IldusV/smartwatch/README.md

1. Download https://github.com/lvgl/lvgl library into the root directory of the smartwatch project
3. Add fb_tft display driver into linux kerner directory for GC9A01A  
4. Add CST816S touchscreen driver into the kernel directory
5. Configure Device Tree
