IldusV/smartwatch/(threads)

Thread 3 (2024-05-27):

GUI stuck

IldusV, 2024-05-27:
However evdev handler for example seem to be running since it still prints touches.

IldusV, 2024-06-18:
This problem seems to be coming up because of animation. Without an animation clock run for a couple of hours without issue.
