IldusV/smartwatch/hardware/PCB/Smartwatch_rev_B.pdf

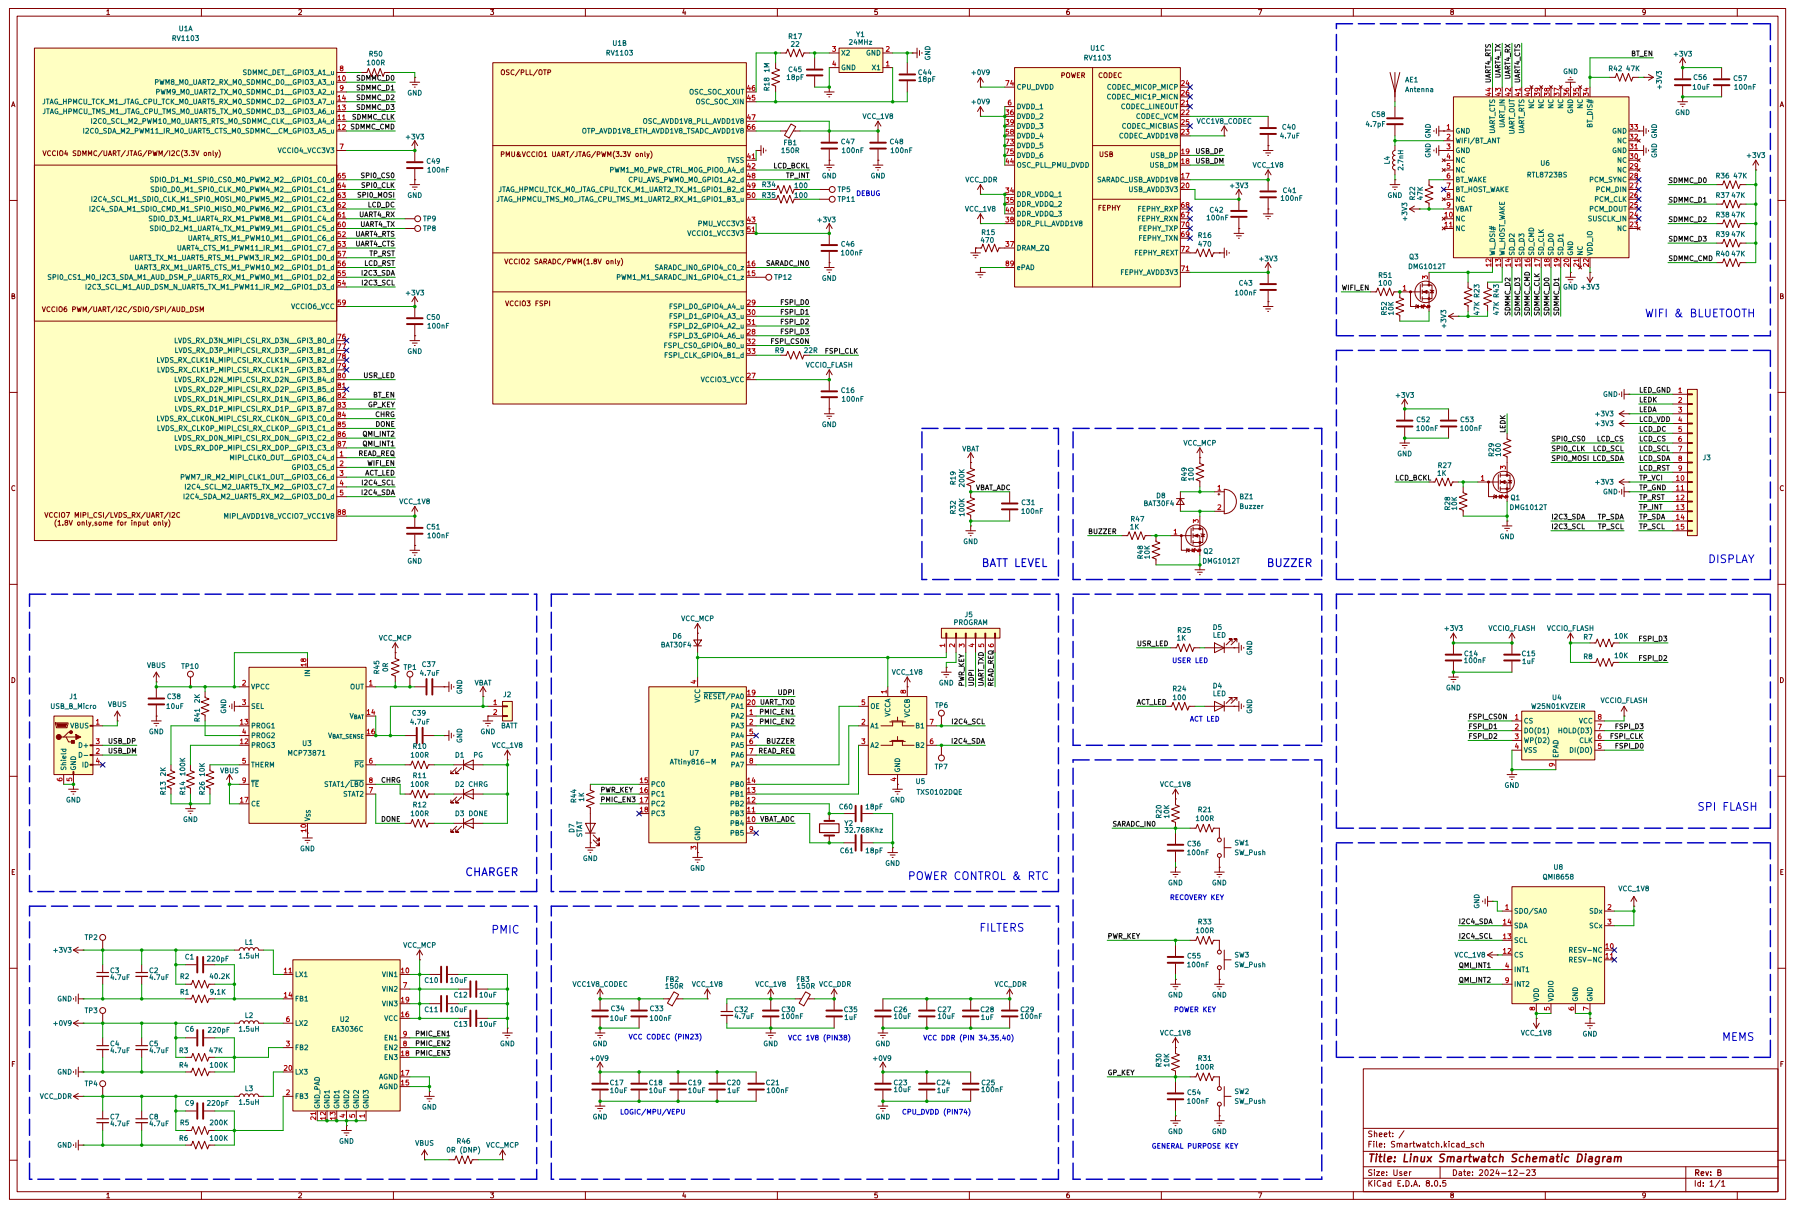
[picture p1: page 1]
