IldusV/smartwatch/hardware/PCB/Smartwatch_rev_A.pdf

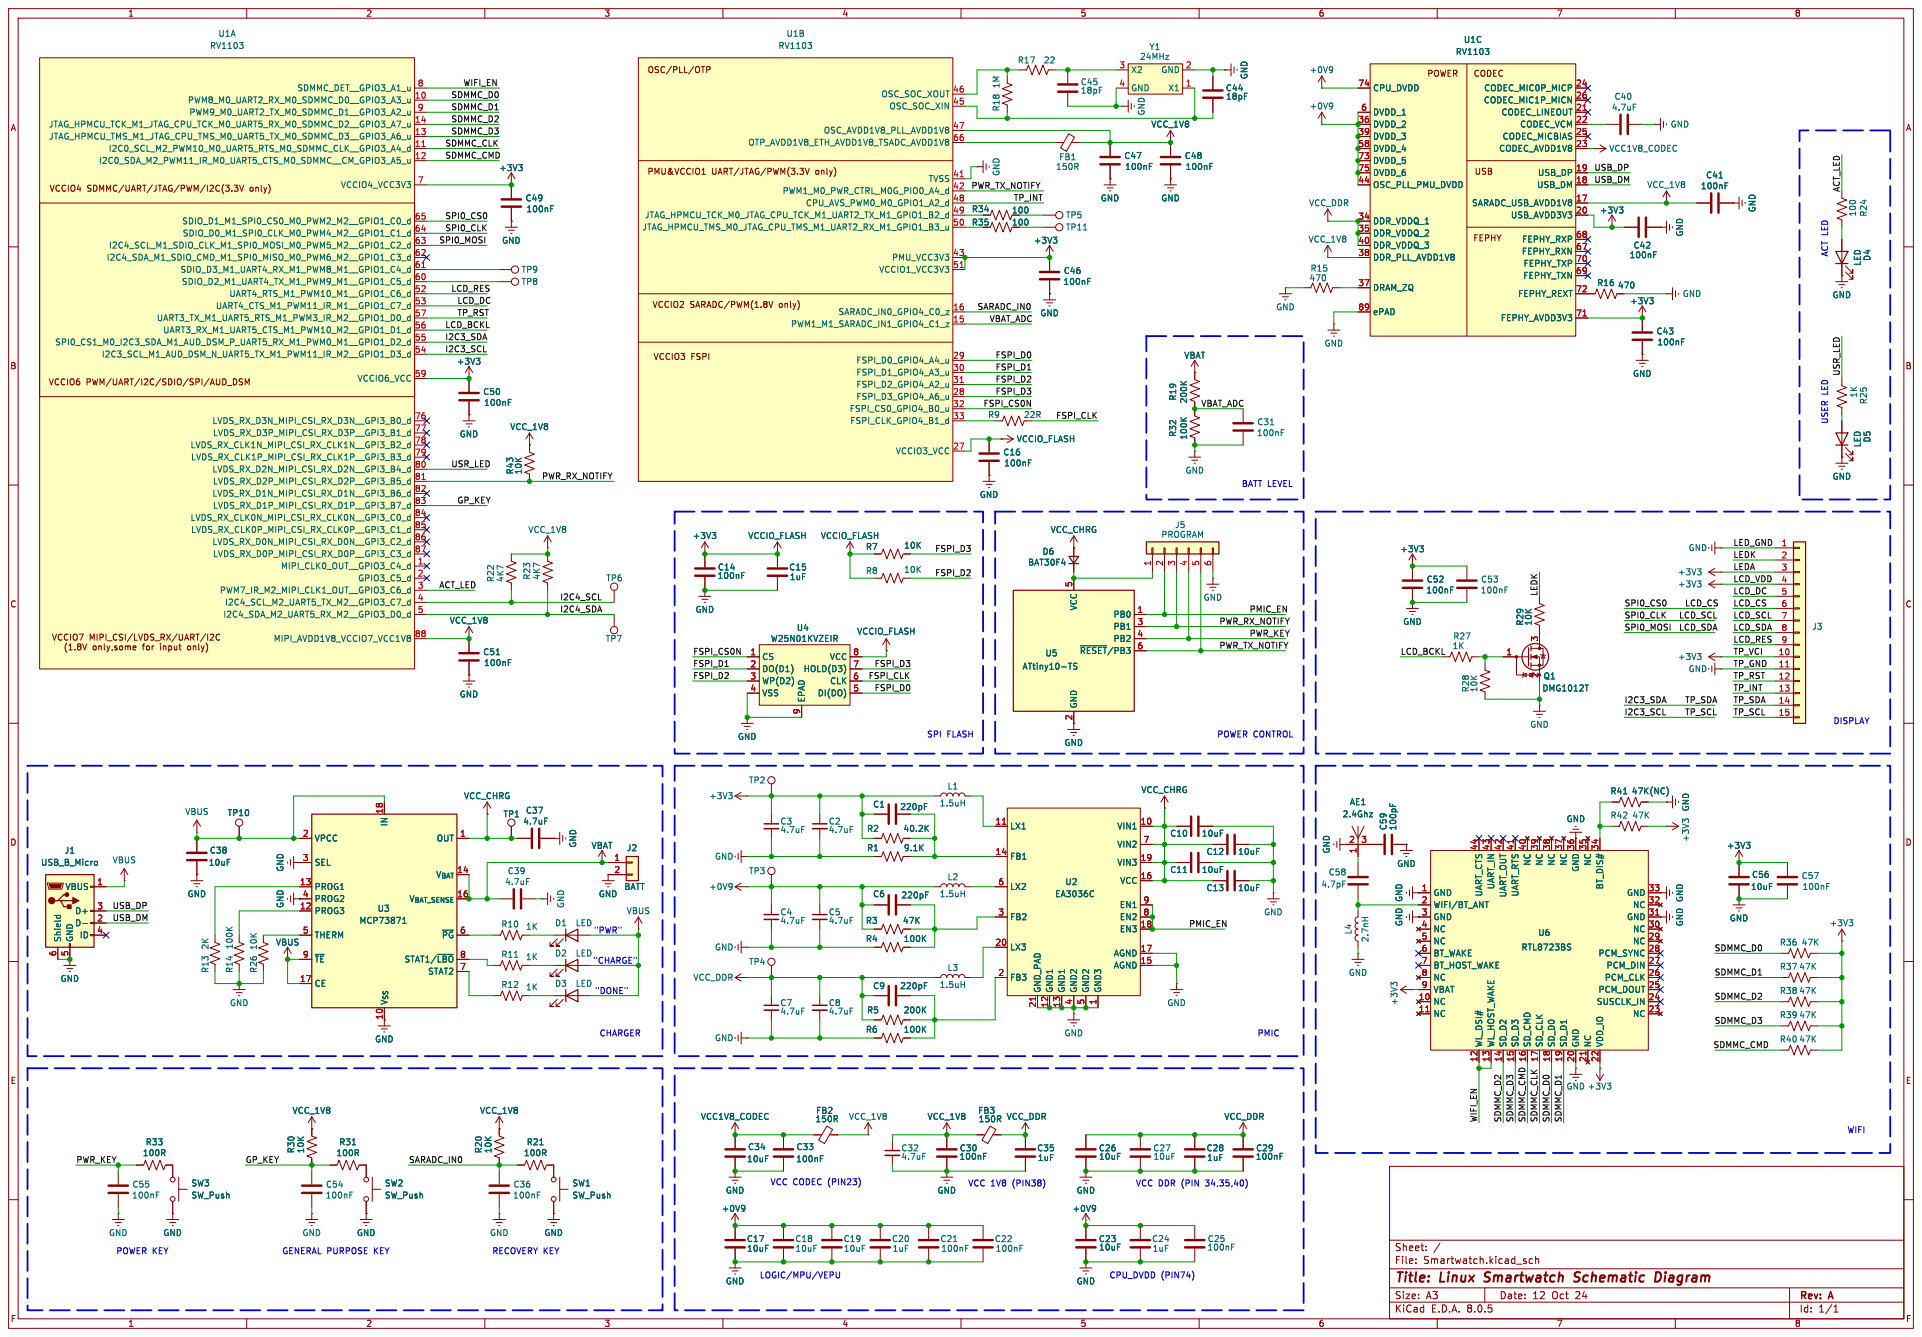
[picture p2: page 1]

VCC CODEC (PIN23) LOGIC/MPU/VEPU GENERAL PURPOSE KEY

Id: 1/1 Title: Linux Smartwatch Schematic Diagram
