IldusV/smartwatch/hardware/PCB/Smartwatch.kicad_pcb

## KiCad design hardware/PCB/Smartwatch.kicad_pcb (2024-10-13)

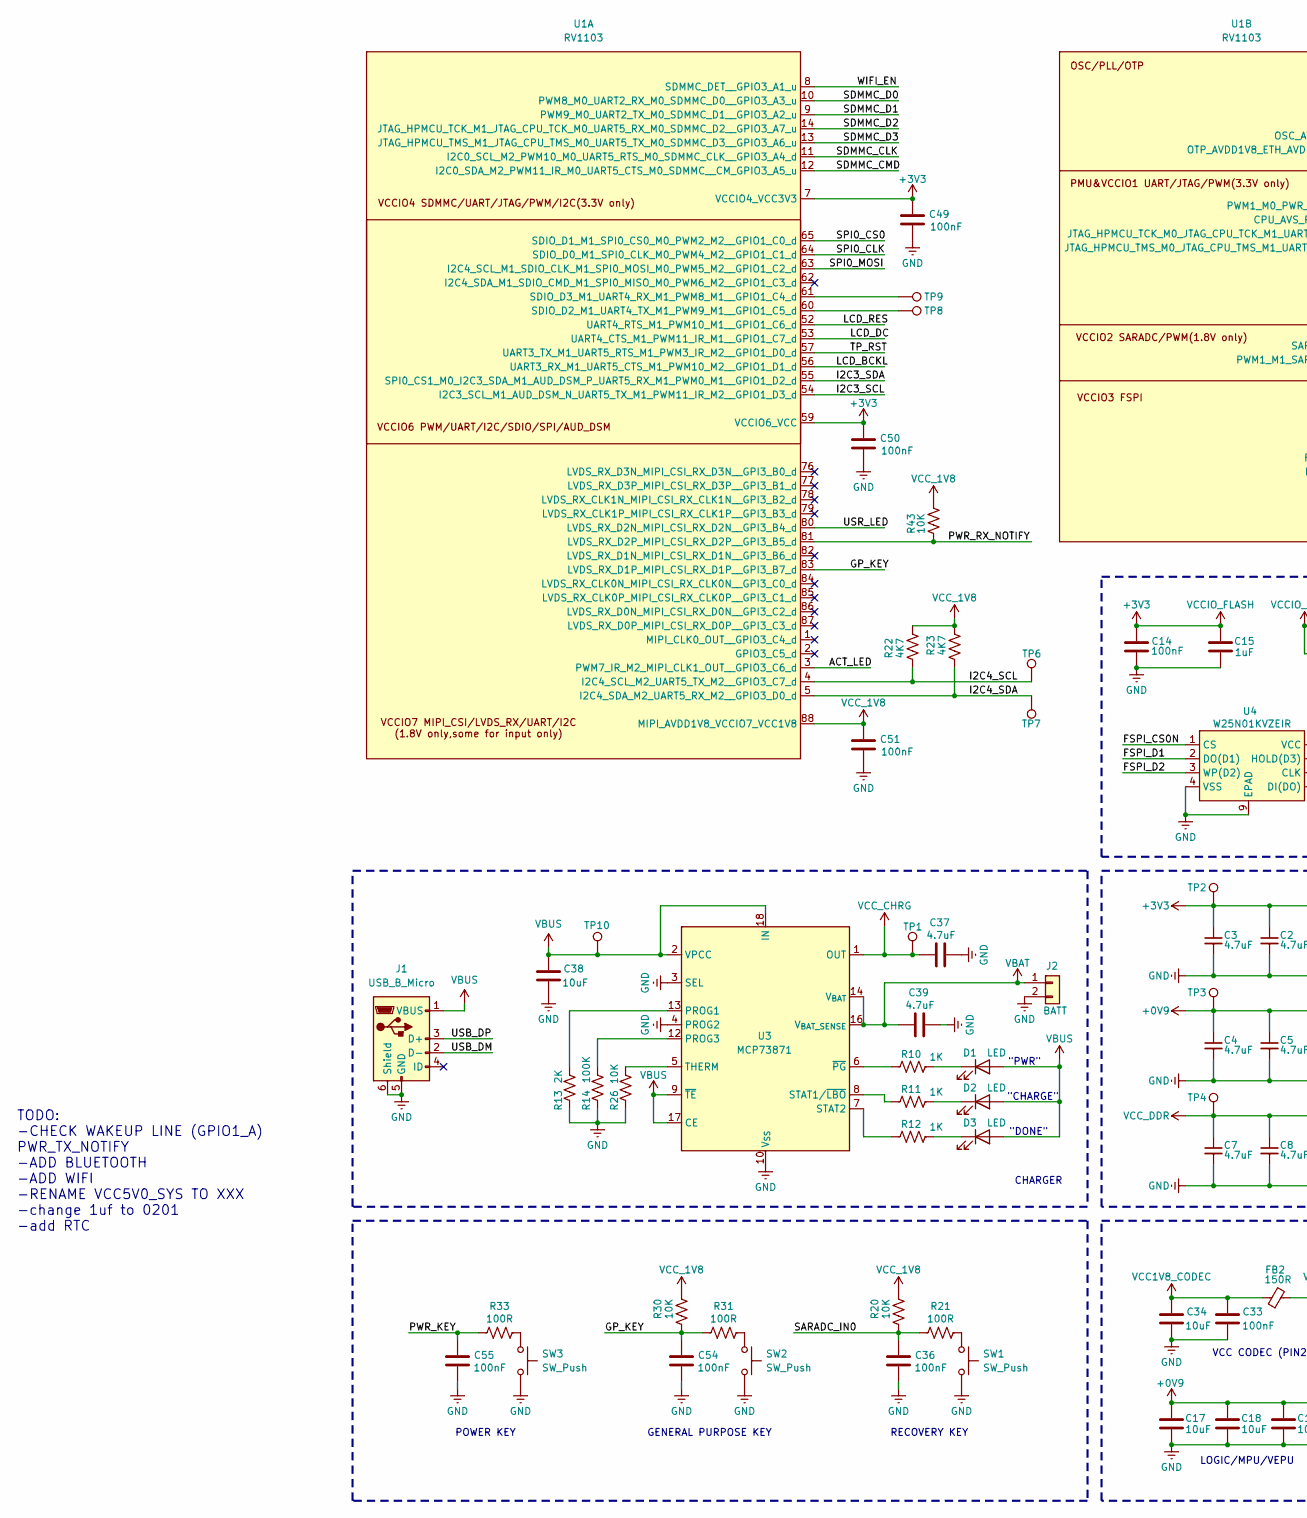
[picture p3: schematic Smartwatch.kicad_sch, Linux Smartwatch Schematic Diagram, part in row 1, column 1]

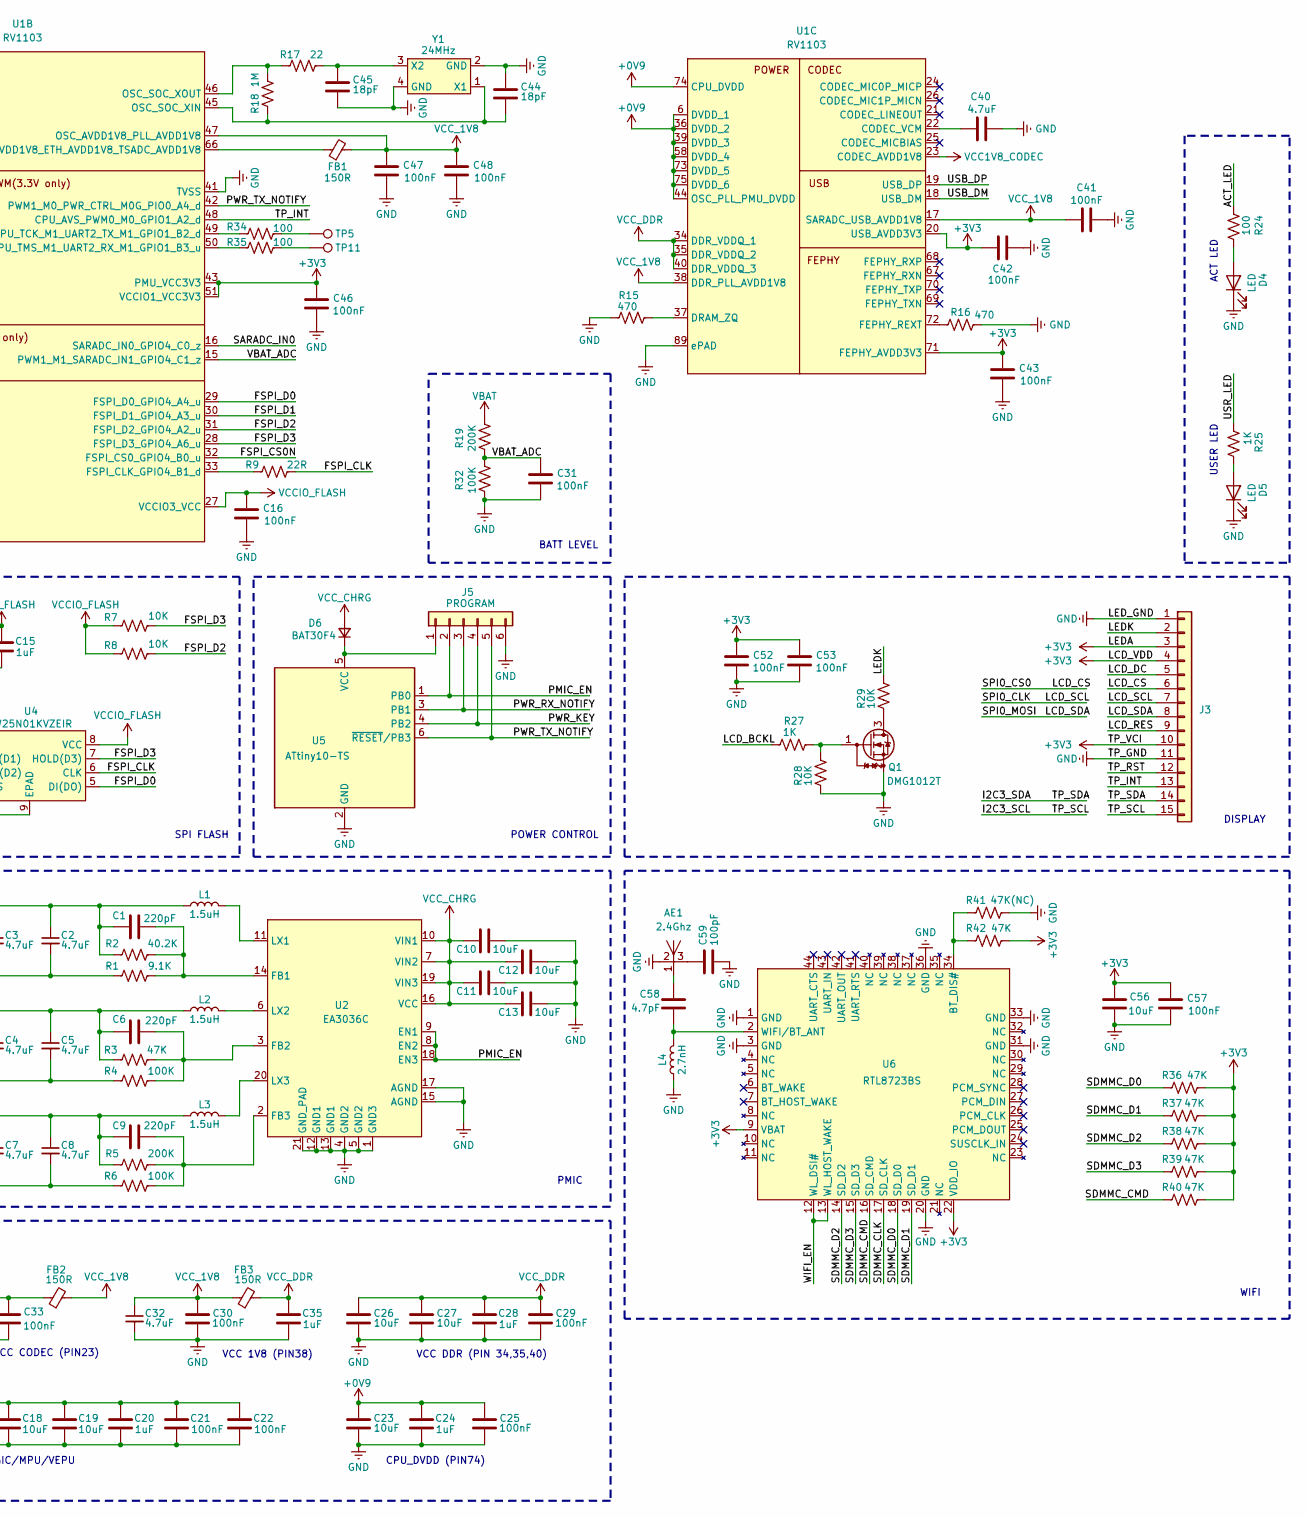
[picture p4: schematic Smartwatch.kicad_sch, Linux Smartwatch Schematic Diagram, part in row 1, column 2]

Parts:
AE1: 2.4Ghz; 2.4Ghz_TE_Antenna
C1, C6, C9: 220pF; C_0201_0603Metric
C2, C3, C4, C5, C7, C8, C32, C37, C39, C40: 4.7uF; C_0201_0603Metric
C10, C11, C12, C13, C17, C18, C19, C23, C26, C27, C34, C38, C56: 10uF; C_0402_1005Metric
C14, C16, C21, C22, C25, C29, C30, C31, C33, C36, C41, C42, C43, C46, C47, C48, C49, C50, C51, C52, C53, C54, C55, C57: 100nF; C_0201_0603Metric
C15, C20, C24, C28, C35: 1uF; C_0201_0603Metric
C44, C45: 18pF; C_0201_0603Metric
C58: 4.7pF; C_0201_0603Metric
C59: 100pF; C_0201_0603Metric
D1, D2, D3, D4, D5: LED; LED_0201_0603Metric
D6: BAT30F4; D_0201_0603Metric
FB1, FB2, FB3: 150R; L_0402_1005Metric
J1: USB_B_Micro; USB_Micro-B_Molex_47346-0001
J2: BATT; JST_Aliexpress_KAN_shop_1x02-1MP_P0.80mm_Horizontal
J3: Conn_01x15; Amphenol_1x15-1MP_P0.5mm_Horizontal
J5: PROGRAM; pinpad6
L1, L2, L3: 1.5uH; L_1008_2520Metric
L4: 2.7nH; L_0402_1005Metric
Q1: DMG1012T; SOT-523
R1: 9.1K; R_0201_0603Metric
R2: 40.2K; R_0201_0603Metric
R3, R36, R37, R38, R39, R40, R42: 47K; R_0201_0603Metric
R4, R6, R14, R32: 100K; R_0201_0603Metric
R5, R19: 200K; R_0201_0603Metric
R7, R8, R20, R26, R28, R29, R30, R43: 10K; R_0201_0603Metric
R9: 22R; R_0201_0603Metric
R10, R11, R12, R25, R27: 1K; R_0201_0603Metric
R13: 2K; R_0201_0603Metric
R15, R16: 470; R_0201_0603Metric
R17: 22; R_0201_0603Metric
R18: 1M; R_0201_0603Metric
R21, R31, R33: 100R; R_0201_0603Metric
R22, R23: 4K7; R_0201_0603Metric
R24, R34, R35: 100; R_0201_0603Metric
R41: 47K(NC); R_0201_0603Metric
SW1, SW2, SW3: SW_Push; SW_1.8x4.5x3.5
TP1, TP2, TP3, TP4, TP5, TP6, TP7, TP8, TP9, TP10, TP11: TestPoint; TP
U1: RV1103; QFN-88_EP_9x9_Pitch0.35mm
U2: EA3036C; QFN-20-1EP_3x3mm_P0.4mm_EP1.65x1.65mm
U3: MCP73871; QFN-20-1EP_4x4mm_P0.5mm_EP2.5x2.5mm
U4: W25N01KVZEIR; WSON-8-1EP_8x6mm_P1.27mm_EP3.4x4.3mm
U5: ATtiny10-TS; SOT-23-6
U6: RTL8723BS; QFN-44_12.64x12.64_Pitch0.9mm
Y1: 24MHz; Crystal_SMD_2016-4Pin_2.0x1.6mm

Connections:
+0V9: C4.1, C5.1, C6.1, C17.1, C18.1, C19.1, C20.1, C21.2, C22.2, C23.1, C24.1, C25.2, L2.1, R3.1, TP3.1, U1.6 (DVDD_1), U1.36 (DVDD_2), U1.39 (DVDD_3), U1.44 (OSC_PLL_PMU_DVDD), U1.58 (DVDD_4), U1.73 (DVDD_5), U1.74 (CPU_DVDD), U1.75 (DVDD_6)
+3V3: C1.1, C2.1, C3.1, C14.2, C15.1, C16.2, C42.2, C43.2, C46.2, C49.2, C50.2, C52.2, C53.2, C56.1, C57.2, J3.3, J3.4, J3.10, L1.1, R2.1, R7.1, R8.1, R36.2, R37.2, R38.2, R39.2, R40.2, R42.2, TP2.1, U1.7 (VCCIO4_VCC3V3), U1.20 (USB_AVDD3V3), U1.27 (VCCIO3_VCC), U1.43 (PMU_VCC3V3), U1.51 (VCCIO1_VCC3V3), U1.59 (VCCIO6_VCC), U1.71 (FEPHY_AVDD3V3), U4.8 (VCC), U6.9 (VBAT), U6.22 (VDD_IO)
/ACT_LED: R24.1, U1.3 (PWM7_IR_M2_MIPI_CLK1_OUT__GPIO3_C6_d)
/FSPI_CLK: R9.2, U4.6 (CLK)
/FSPI_CS0N: U1.32 (FSPI_CS0_GPIO4_B0_u), U4.1 (CS)
/FSPI_D0: U1.29 (FSPI_D0_GPIO4_A4_u), U4.5 (DI(DO))
/FSPI_D1: U1.30 (FSPI_D1_GPIO4_A3_u), U4.2 (DO(D1))
/FSPI_D2: R8.2, U1.31 (FSPI_D2_GPIO4_A2_u), U4.3 (WP(D2))
/FSPI_D3: R7.2, U1.28 (FSPI_D3_GPIO4_A6_u), U4.7 (HOLD(D3))
/GP_KEY: C54.2, R30.1, R31.1, U1.83 (LVDS_RX_D1P_MIPI_CSI_RX_D1P__GPI3_B7_d)
/I2C3_SCL: J3.15, U1.54 (I2C3_SCL_M1_AUD_DSM_N_UART5_TX_M1_PWM11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)
/I2C3_SDA: J3.14, U1.55 (SPI0_CS1_M0_I2C3_SDA_M1_AUD_DSM_P_UART5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)
/I2C4_SCL: R22.1, TP6.1, U1.4 (I2C4_SCL_M2_UART5_TX_M2__GPIO3_C7_d)
/I2C4_SDA: R23.1, TP7.1, U1.5 (I2C4_SDA_M2_UART5_RX_M2__GPIO3_D0_d)
/LCD_BCKL: R27.1, U1.56 (UART3_RX_M1_UART5_CTS_M1_PWM10_M2__GPIO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)
/LCD_CS: J3.6, U1.65 (SDIO_D1_M1_SPI0_CS0_M0_PWM2_M2__GPIO1_C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)
/LCD_DC: J3.5, U1.53 (UART4_CTS_M1_PWM11_IR_M1__GPIO1_C7_d)
/LCD_RES: J3.9, U1.52 (UART4_RTS_M1_PWM10_M1__GPIO1_C6_d)
/LCD_SCL: J3.7, U1.64 (SDIO_D0_M1_SPI0_CLK_M0_PWM4_M2__GPIO1_C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)
/LCD_SDA: J3.8, U1.63 (I2C4_SCL_M1_SDIO_CLK_M1_SPI0_MOSI_M0_PW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)
/LEDK: J3.2, R29.2
/PMIC_EN: J5.2, U2.8 (EN2), U2.9 (EN1), U2.18 (EN3), U5.1 (PB0)
/PWR_KEY: C55.2, J5.4, R33.1, U5.4 (PB2)
/PWR_RX_NOTIFY: J5.3, R43.1, U1.81 (LVDS_RX_D2P_MIPI_CSI_RX_D2P__GPI3_B5_d), U5.3 (PB1)
/PWR_TX_NOTIFY: J5.5, U1.42 (PWM1_M0_PWR_CTRL_M0G_PIO0_A4_d), U5.6 (~RESET/PB3)
/SARADC_IN0: C36.2, R20.1, R21.1, U1.16 (SARADC_IN0_GPIO4_C0_z)
/SDMMC_CLK: U1.11 (I2C0_SCL_M2_PWM10_M0_UART5_RTS_M0_SDMMC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), U6.17 (SD_CLK)
/SDMMC_CMD: R40.1, U1.12 (I2C0_SDA_M2_PWM11_IR_M0_UART5_CTS_M0_SD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), U6.16 (SD_CMD)
/SDMMC_D0: R36.1, U1.10 (PWM8_M0_UART2_RX_M0_SDMMC_D0__GPIO3_A3_u), U6.18 (SD_D0)
/SDMMC_D1: R37.1, U1.9 (PWM9_M0_UART2_TX_M0_SDMMC_D1__GPIO3_A2_u), U6.19 (SD_D1)
/SDMMC_D2: R38.1, U1.14 (JTAG_HPMCU_TCK_M1_JTAG_CPU_TCK_M0_UART5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), U6.14 (SD_D2)
/SDMMC_D3: R39.1, U1.13 (JTAG_HPMCU_TMS_M1_JTAG_CPU_TMS_M0_UART5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), U6.15 (SD_D3)
/TP_INT: J3.13, U1.48 (CPU_AVS_PWM0_M0_GPIO1_A2_d)
/TP_RST: J3.12, U1.57 (UART3_TX_M1_UART5_RTS_M1_PWM3_IR_M2__GP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)
/USB_DM: J1.2 (D-), U1.18 (USB_DM)
/USB_DP: J1.3 (D+), U1.19 (USB_DP)
/USR_LED: R25.1, U1.80 (LVDS_RX_D2N_MIPI_CSI_RX_D2N__GPI3_B4_d)
/VBAT_ADC: C31.2, R19.1, R32.2, U1.15 (PWM1_M1_SARADC_IN1_GPIO4_C1_z)
/WIFI_EN: U1.8 (SDMMC_DET__GPIO3_A1_u), U6.12 (WL_DSI#), U6.13 (WL_HOST_WAKE)
GND: AE1.2, C2.2, C3.2, C4.2, C5.2, C7.2, C8.2, C10.1, C11.1, C12.1, C13.1, C14.1, C15.2, C16.1, C17.2, C18.2, C19.2, C20.2, C21.1, C22.1, C23.2, C24.2, C25.1, C26.2, C27.2, C28.2, C29.1, C30.1, C31.1, C32.2, C33.1, C34.2, C35.2, C36.1, C37.2, C38.2, C39.2, C40.2, C41.2, C42.1, C43.1, C44.2, C45.1, C46.1, C47.1, C48.1, C49.1, C50.1, C51.1, C52.1, C53.1, C54.1, C55.1, C56.2, C57.1, C59.2, D4.1 (K), D5.1 (K), J1.5 (GND), J1.6 (Shield), J2.2, J3.1, J3.11, J5.6, L4.1, Q1.2 (S), R1.1, R4.1, R6.1, R13.1, R14.1, R15.1, R16.2, R26.1, R28.1, R32.1, R41.2, SW1.2, SW2.2, SW3.2, U1.41 (TVSS), U1.89 (ePAD), U2.1 (GND3), U2.4 (GND2), U2.5 (GND2), U2.12 (GND1), U2.13 (GND1), U2.15 (AGND), U2.17 (AGND), U2.21 (GND_PAD), U3.3 (SEL), U3.4 (PROG2), U3.10 (V_{SS}), U3.11 (V_{SS}), U3.21 (V_{SS}), U4.4 (VSS), U4.9 (EPAD), U5.2 (GND), U6.1 (GND), U6.3 (GND), U6.20 (GND), U6.31 (GND), U6.33 (GND), U6.36 (GND), Y1.2 (GND), Y1.4 (GND)
unnamed: AE1.1, C58.2
unnamed: AE1.3, C59.1
unnamed: D1.1 (K), R10.2
unnamed: D2.1 (K), R11.2
unnamed: D3.1 (K), R12.2
unnamed: D4.2 (A), R24.2
unnamed: D5.2 (A), R25.2
unnamed: D6.1 (K), J5.1, U5.5 (VCC)
unnamed: Q1.3 (D), R29.1
unnamed: Q1.1 (G), R27.2, R28.2
unnamed: R21.2, SW1.1
unnamed: R31.2, SW2.1
unnamed: R33.2, SW3.1
unnamed: R34.2, TP5.1
unnamed: R35.2, TP11.1
unnamed: TP8.1, U1.60 (SDIO_D2_M1_UART4_TX_M1_PWM9_M1__GPIO1_C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)
unnamed: TP9.1, U1.61 (SDIO_D3_M1_UART4_RX_M1_PWM8_M1__GPIO1_C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)
unnamed: R9.1, U1.33 (FSPI_CLK_GPIO4_B1_d)
unnamed: R34.1, U1.49 (JTAG_HPMCU_TCK_M0_JTAG_CPU_TCK_M1_UART2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)
unnamed: R35.1, U1.50 (JTAG_HPMCU_TMS_M0_JTAG_CPU_TMS_M1_UART2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)
unnamed: C44.1, R18.1, U1.45 (OSC_SOC_XIN), Y1.1 (X1)
unnamed: R17.1, R18.2, U1.46 (OSC_SOC_XOUT)
unnamed: FB1.1, U1.66 (OTP_AVDD1V8_ETH_AVDD1V8_TSADC_AVDD1V8)
unnamed: C40.1, U1.22 (CODEC_VCM)
unnamed: R15.2, U1.37 (DRAM_ZQ)
unnamed: R16.1, U1.72 (FEPHY_REXT)
unnamed: C1.2, R1.2, R2.2, U2.14 (FB1)
unnamed: C6.2, R3.2, R4.2, U2.3 (FB2)
unnamed: C9.2, R5.2, R6.2, U2.2 (FB3)
unnamed: L1.2, U2.11 (LX1)
unnamed: L2.2, U2.6 (LX2)
unnamed: L3.2, U2.20 (LX3)
unnamed: R13.2, U3.13 (PROG1)
unnamed: R14.2, U3.12 (PROG3)
unnamed: R11.1, U3.8 (STAT1/~LBO)
unnamed: R12.1, U3.7 (STAT2)
unnamed: R26.2, U3.5 (THERM)
unnamed: R10.1, U3.6 (~PG)
unnamed: R41.1, R42.1, U6.34 (BT_DIS#)
unnamed: C58.1, L4.2, U6.2 (WIFI/BT_ANT)
unnamed: C45.2, R17.2, Y1.3 (X2)
VBAT: C39.1, J2.1, R19.2, U3.14 (V_{BAT}), U3.15 (V_{BAT}), U3.16 (V_{BAT_SENSE})
VBUS: C38.1, D1.2 (A), D2.2 (A), D3.2 (A), J1.1 (VBUS), TP10.1, U3.2 (VPCC), U3.9 (~TE), U3.17 (CE), U3.18 (IN), U3.19 (IN)
VCC1V8_CODEC: C33.2, C34.1, FB2.1, U1.23 (CODEC_AVDD1V8)
VCC_1V8: C30.2, C32.1, C41.1, C47.2, C48.2, C51.2, FB1.2, FB2.2, FB3.1, R20.2, R22.2, R23.2, R30.2, R43.2, U1.17 (SARADC_USB_AVDD1V8), U1.38 (DDR_PLL_AVDD1V8), U1.47 (OSC_AVDD1V8_PLL_AVDD1V8), U1.88 (MIPI_AVDD1V8_VCCIO7_VCC1V8)
VCC_CHRG: C10.2, C11.2, C12.2, C13.2, C37.1, D6.2 (A), TP1.1, U2.7 (VIN2), U2.10 (VIN1), U2.16 (VCC), U2.19 (VIN3), U3.1 (OUT), U3.20 (OUT)
VCC_DDR: C7.1, C8.1, C9.1, C26.1, C27.1, C28.1, C29.2, C35.1, FB3.2, L3.1, R5.1, TP4.1, U1.34 (DDR_VDDQ_1), U1.35 (DDR_VDDQ_2), U1.40 (DDR_VDDQ_3)

Notes on the sheet:
"DONE"
POWER CONTROL
LOGIC/MPU/VEPU
ACT LED
"PWR"
GENERAL PURPOSE KEY
CPU_DVDD (PIN74)
VCC CODEC (PIN23)
"CHARGE"
RECOVERY KEY
WIFI
CHARGER
SPI FLASH
BATT LEVEL
DISPLAY
USER LED
VCC DDR (PIN 34,35,40)
PMIC
TODO: -CHECK WAKEUP LINE (GPIO1_A) PWR_TX_NOTIFY -ADD BLUETOOTH -ADD WIFI -RENAME VCC5V0_SYS TO XXX -change 1uf to 0201 -add RTC
VCC 1V8 (PIN38)
POWER KEY

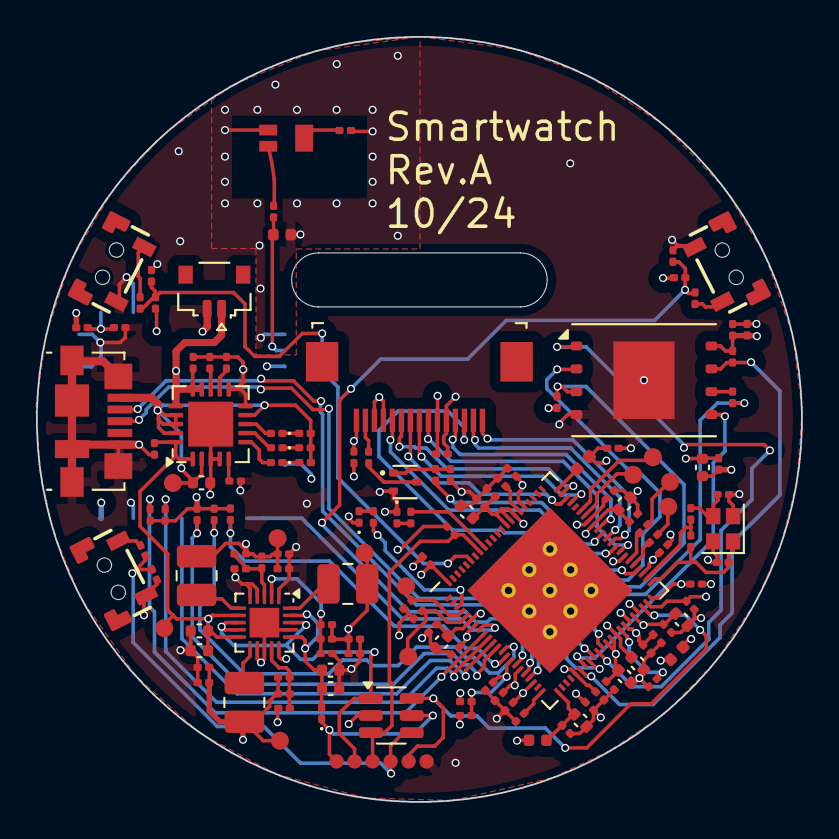
[picture p5: board Smartwatch.kicad_pcb from above]

Board: 4 copper layers, 42.5 x 42.5 mm, 142 parts (1 on the bottom side), 87 nets.
