IldusV/smartwatch/os_drv/fb_ili9340.c

// SPDX-License-Identifier: GPL-2.0+
/*
 * FB driver for the ILI9340 LCD Controller
 *
 * Copyright (C) 2013 Noralf Tronnes
 */

#include <linux/module.h>
#include <linux/kernel.h>
#include <linux/init.h>
#include <linux/delay.h>
#include <video/mipi_display.h>

#include "fbtft.h"

#define DRVNAME		"fb_ili9340"
#define WIDTH		240
//#define HEIGHT		320
#define HEIGHT		240

/* Init sequence taken from: Arduino Library for the Adafruit 2.2" display */
static int init_display(struct fbtft_par *par)
{
	par->fbtftops.reset(par);

	write_reg(par, 0x11); /* Sleep mode OFF */
	mdelay(120); /* Delay 120ms */
	write_reg(par, 0xEF); /* Inter register enable 2 */
	write_reg(par, 0xEB,0x14);//
	/* BEGIN set inter_command HIGH */
	write_reg(par, 0xFE);//
	write_reg(par, 0xEF);//
	/* END set inter_command HIGH */
	write_reg(par, 0xEB, 0x14);//ok
	write_reg(par, 0x84, 0x40);//
	write_reg(par, 0x85, 0xFF);//
	write_reg(par, 0x86, 0xFF);//
	write_reg(par, 0x87, 0xFF);//
	write_reg(par, 0x88, 0x0A);//
	write_reg(par, 0x89, 0x21);//
	write_reg(par, 0x8A, 0x00);//
	write_reg(par, 0x8B, 0x80);//
	write_reg(par, 0x8C, 0x01);//
	write_reg(par, 0x8D, 0x01);//
	write_reg(par, 0x8E, 0xFF);//
	write_reg(par, 0x8F, 0xFF);//
	write_reg(par, 0xB6, 0x00, 0x00); /* Display function control *///
	write_reg(par, 0x36, 0x48); /* Memory access control */ //08->48
	write_reg(par, 0x3A, 0x05); /* Pixel format *///
	write_reg(par, 0x90, 0x08, 0x08, 0x08, 0x08);//
	write_reg(par, 0xBD, 0x06);//
	write_reg(par, 0xBC, 0x00);//
	write_reg(par, 0xFF, 0x60, 0x01, 0x04);//
	write_reg(par, 0xC3, 0x13); /* Voltage regulator 1a *///
	write_reg(par, 0xC4, 0x13); /* Voltage regulator 1b *///
	write_reg(par, 0xC9, 0x22); /* Voltage regulator 2a *///
	write_reg(par, 0xBE, 0x11);//
	write_reg(par, 0xE1, 0x10, 0x0E);//
	write_reg(par, 0xDF, 0x21, 0x0C, 0x02);//
	write_reg(par, 0xF0, 0x45, 0x09, 0x08, 0x08, 0x26, 0x2A); /* Set gamma1 *///
	write_reg(par, 0xF1, 0x43, 0x70, 0x72, 0x36, 0x37, 0x6F); /* Set gamma2 *///
	write_reg(par, 0xF2, 0x45, 0x09, 0x08, 0x08, 0x26, 0x2A); /* Set gamma3 *///
	write_reg(par, 0xF3, 0x43, 0x70, 0x72, 0x36, 0x37, 0x6F); /* Set gamma4 *///
	write_reg(par, 0xED, 0x1B, 0x0B);//
	write_reg(par, 0xAE, 0x77);//
	write_reg(par, 0xCD, 0x63);//
	write_reg(par, 0x70, 0x07, 0x07, 0x04, 0x0E, 0x0F, 0x09, 0x07, 0x08, 0x03);//
	write_reg(par, 0xE8, 0x34); /* Frame rate *///
	write_reg(par, 0x62, 0x18, 0x0D, 0x71, 0xED, 0x70, 0x70, 0x18, 0x0F, 0x71, 0xEF, 0x70, 0x70); //
	write_reg(par, 0x63, 0x18, 0x11, 0x71, 0xF1, 0x70, 0x70, 0x18, 0x13, 0x71, 0xF3, 0x70, 0x70);//
	write_reg(par, 0x64, 0x28, 0x29, 0xF1, 0x01, 0xF1, 0x00, 0x07);//
	write_reg(par, 0x66, 0x3C, 0x00, 0xCD, 0x67, 0x45, 0x45, 0x10, 0x00, 0x00, 0x00);//
	write_reg(par, 0x67, 0x00, 0x3C, 0x00, 0x00, 0x00, 0x01, 0x54, 0x10, 0x32, 0x98);//
	write_reg(par, 0x74, 0x10, 0x85, 0x80, 0x00, 0x00, 0x4E, 0x00);//
	write_reg(par, 0x98, 0x3e, 0x07);//
	write_reg(par, 0x35); /* Tearing effect ON *///
	write_reg(par, 0x21); /* Display inversion ON *///
	write_reg(par, 0x11); /* Sleep mode OFF */
	write_reg(par, 0x38); //idle mode off
	mdelay(120); /* Delay 120ms */
	write_reg(par, 0x29); /* Display ON */
	mdelay(20); /* Delay 20ms */

	// write_reg(par, 0xCB, 0x39, 0x2C, 0x00, 0x34, 0x02);
	// write_reg(par, 0xF7, 0x20);
	// write_reg(par, 0xEA, 0x00, 0x00);

	// /* Power Control 1 */
	// write_reg(par, 0xC0, 0x23);

	// /* Power Control 2 */
	// write_reg(par, 0xC1, 0x10);

	// /* VCOM Control 1 */
	// write_reg(par, 0xC5, 0x3e, 0x28);

	// /* VCOM Control 2 */
	// write_reg(par, 0xC7, 0x86);

	// /* COLMOD: Pixel Format Set */
	// /* 16 bits/pixel */
	// write_reg(par, MIPI_DCS_SET_PIXEL_FORMAT, 0x55);

	// /* Frame Rate Control */
	// /* Division ratio = fosc, Frame Rate = 79Hz */
	// write_reg(par, 0xB1, 0x00, 0x18);

	// /* Display Function Control */
	// write_reg(par, 0xB6, 0x08, 0x82, 0x27);

	// /* Gamma Function Disable */
	// write_reg(par, 0xF2, 0x00);

	// /* Gamma curve selection */
	// write_reg(par, MIPI_DCS_SET_GAMMA_CURVE, 0x01);

	// /* Positive Gamma Correction */
	// write_reg(par, 0xE0,
	// 	  0x0F, 0x31, 0x2B, 0x0C, 0x0E, 0x08, 0x4E, 0xF1,
	// 	  0x37, 0x07, 0x10, 0x03, 0x0E, 0x09, 0x00);

	// /* Negative Gamma Correction */
	// write_reg(par, 0xE1,
	// 	  0x00, 0x0E, 0x14, 0x03, 0x11, 0x07, 0x31, 0xC1,
	// 	  0x48, 0x08, 0x0F, 0x0C, 0x31, 0x36, 0x0F);

	// write_reg(par, MIPI_DCS_EXIT_SLEEP_MODE);

	// mdelay(120);

	// write_reg(par, MIPI_DCS_SET_DISPLAY_ON);

	return 0;
}

static void set_addr_win(struct fbtft_par *par, int xs, int ys, int xe, int ye)
{
	write_reg(par, MIPI_DCS_SET_COLUMN_ADDRESS,
		  xs >> 8, xs & 0xFF, xe >> 8, xe & 0xFF);

	write_reg(par, MIPI_DCS_SET_PAGE_ADDRESS,
		  ys >> 8, ys & 0xFF, ye >> 8, ye & 0xFF);

	write_reg(par, MIPI_DCS_WRITE_MEMORY_START);
}

#define ILI9340_MADCTL_MV  0x20
#define ILI9340_MADCTL_MX  0x40
#define ILI9340_MADCTL_MY  0x80
static int set_var(struct fbtft_par *par)
{
	u8 val;

	switch (par->info->var.rotate) {
	case 270:
		val = ILI9340_MADCTL_MV;
		break;
	case 180:
		val = ILI9340_MADCTL_MY;
		break;
	case 90:
		val = ILI9340_MADCTL_MV | ILI9340_MADCTL_MY | ILI9340_MADCTL_MX;
		break;
	default:
		val = ILI9340_MADCTL_MX;
		break;
	}
	/* Memory Access Control  */
	//write_reg(par, MIPI_DCS_SET_ADDRESS_MODE, val | (par->bgr << 3));

	//ildusv: hardcode par->bgr to 1 as it's being read as 0 although BGR bit is set to 1 in 36h
	//this leads to swapping of color bytes from RGB to BGR
	write_reg(par, MIPI_DCS_SET_ADDRESS_MODE, val | (1 << 3));
	return 0;
}

static struct fbtft_display display = {
	.regwidth = 8,
	.width = WIDTH,
	.height = HEIGHT,
	.fbtftops = {
		.init_display = init_display,
		.set_addr_win = set_addr_win,
		.set_var = set_var,
	},
};

FBTFT_REGISTER_DRIVER(DRVNAME, "ilitek,ili9340", &display);

MODULE_ALIAS("spi:" DRVNAME);
MODULE_ALIAS("platform:" DRVNAME);
MODULE_ALIAS("spi:ili9340");
MODULE_ALIAS("platform:ili9340");

MODULE_DESCRIPTION("FB driver for the ILI9340 LCD Controller");
MODULE_AUTHOR("Noralf Tronnes");
MODULE_LICENSE("GPL");
