IldusV/smartwatch/(commit log)

2024-10-13 PCB rev.A completed
    [Smartwatch.kicad_pcb, Smartwatch.kicad_sch]
2024-10-13 PCB rev.A ordered
    [Smartwatch.kicad_pcb]
2024-12-27 PCB rev.B completed
    [Smartwatch.kicad_sch]
